Franck78/Cobra-Command/output/dataeast-EL.pdf

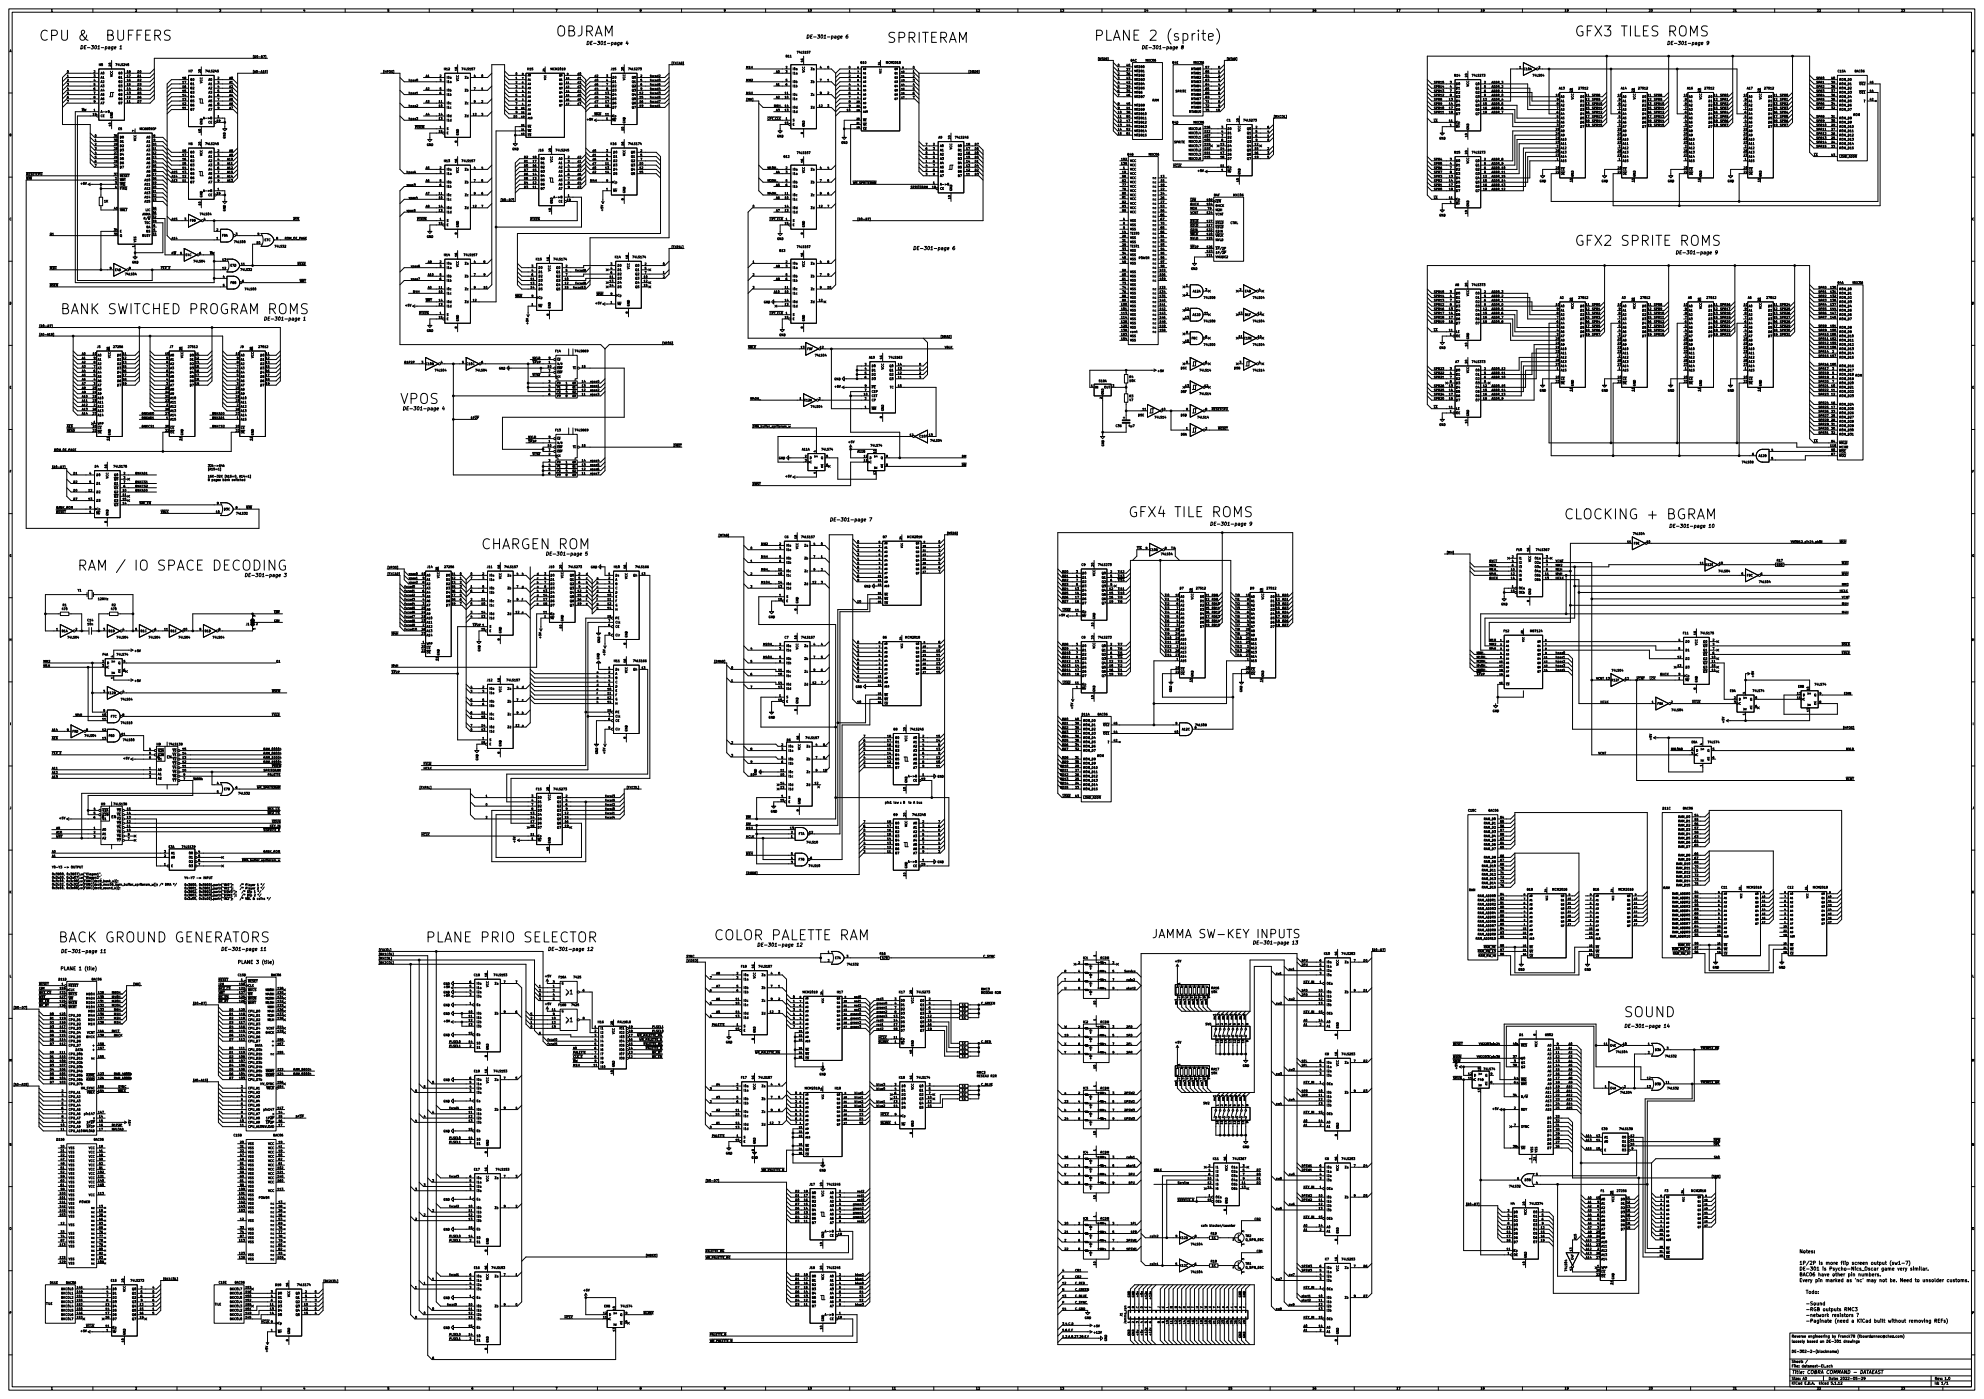
[picture p1: page 1]

BANK SWITCHED PROGRAM ROMS

DMA_buffer_spriteram_w
GND GND

8 Zc 9 C6 74LS157 Mr 1 Q2 10 Q2 11 D2 12 D3 13 Q3 14 Q3 15 VCC 16 Q0 2 Q0 3 D0 4 D1 5 Q1 6 Q1 7 GND

W RAM / IO SPACE DECODING

RMC3 RESEAU R2R BACK GROUND GENERATORS

1P/2P is more flip screen output (sw1-7)
DE-301 is Psycho-Nics_Oscar game very similar.
BAC06 have other pin numbers.
Every pin marked as 'nc' may not be. Need to unsolder customs.

-network resistors ?
-Paginate (need a KiCad built without removing REFs)

Reverse engineering by Franck78 (fbourdonnec@chez.com)
loosely based on DE-301 drawings

File: dataeast-EL.sch Sheet: / DE-302-2-(blockname)

Id: 1/1 Title: COBRA COMMAND - DATAEAST
