Franck78/Cobra-Command/dataeast-EL.sch

## KiCad design dataeast-EL.sch (2024-06-16)

Schematic: dataeast-EL.sch

Parts:
A2, A3, A5, A6, A13, A14, A16, A17: 27512; DIP-28_W15.24mm
A7, A8: 74LS373
A9: 74LS245
A10: 74LS163
A11: 74LS74
A12: 74LS08
B1: 74LS04
B4: MXC06
B6, B7, B10, B16, B18: MCM2018
B8, B9: 74LS245
B11, B12, B13: 74LS157
B14, B15: 74LS273
C1, C8, C9: 74LS273
C6, C7: 74LS157
C10: 74LS04
C11, C12: MCM2018
C14: 10n
C15: BAC06
C18: 74LS153
C36: 4µ7
D1: 6502
D3: 74LS32
D4: 74LS175
D5: 74LS14
D6: 74LS157
D7, D9: 27512; DIP-28_W15.24mm
D11: BAC06
D18: 74LS174
E3: 74LS139
E4: 74LS04
E5: MC6809EP; DIP-40_W15.24mm
E7: 74LS32
E8, E9: 74LS74
E15: 74LS273
E16, E17, E18: 74LS153
F1: 27256; DIP-28_W15.24mm
F3: MCM2018
F4: 74LS74
F7: 74LS10
F8: 74LS00
F9: 74LS04
F10: 74LS367
F11: 74LS175
F12: MB7124
F13, F14: 74LS669
F15: 74LS273
F16: 7425
F17, F18: 74LS157
H4: 74LS374
H5, H6, H7: 74LS245
H8, H9: 74LS138
H10, H11: 74LS166
H12, H13, H14: 74LS157
H15, H17, H18: MCM2018
H16: PAL16L8
IC1, IC2, IC3, IC4, IC5: RCDM
J1: SolderJumper_3_Bridged12
J5, J14: 27256; DIP-28_W15.24mm
J7, J9: 27512; DIP-28_W15.24mm
J10, J15: 74LS273
J11, J12: 74LS157
J16, J17, J18: 74LS245
K7, K8, K9, K10: 74LS253
K11: 74LS367
K12: 74LS04
K14, K15, K16, K18: 74LS174
K17: 74LS273
R1, R2, R16: 470
R3: 47
R4: 10K
R17: 680
R18, R19: 1K
RA16, RA17: 10K; R_Array_SIP9
SW1, SW2: SW1
TR1, TR2: Q_NPN_EBC
Y1: 12MHz

Notes on the sheet:
A13
A14
A15
A10
A11
A12
JAMMA SW-KEY INPUTS
RMC3 RESEAU R2R
GFX2 SPRITE ROMS
GFX4 TILE ROMS
SOUND
GFX3 TILES ROMS
BANK SWITCHED PROGRAM ROMS
32k->64k [A15=1]
16K-32K [A15=0, A14=1] 8 pages bank switched
RAM / IO SPACE DECODING
PLANE PRIO SELECTOR
OBJRAM
CHARGEN ROM
2PU
1PU
1PL
1PR
1PSW1
1PSW2
1PSW3
2PSW1
2PSW2
2PSW3
start1
2PR
2PL
1PD
2PD
start2
coin2
coin1
pin1 low : B to A bus
SPRITERAM
VPOS
Y0-Y3 -> OUTPUT 0x3800, 0x3807).w("tilegen1", 0x3a00, 0x3a07).w("tilegen2", 0x3c00, 0x3c00).w(FUNC(dec8_bank_w)); 0x3c02, 0x3c02).w(FUNC(dec8_mxc06_karn_buffer_spriteram_w)); /* DMA */ 0x3e00, 0x3e00).w(FUNC(dec8_sound_w));
Y4-Y7 -> INPUT 0x3800, 0x3800).portr("IN0"); /* Player 1 */ 0x3801, 0x3801).portr("IN1"); /* Player 2 */ 0x3802, 0x3802).portr("DSW0"); /* Dip 1 */ 0x3803, 0x3803).portr("DSW1"); /* Dip 2 */ 0x3a00, 0x3a00).portr("IN2"); /* VBL & coins */
CPU & BUFFERS
DE-301-page 1
DE-301-page 6
DE-301-page 3
DE-301-page 4
DE-301-page 5
DE-301-page 12
COLOR PALETTE RAM
PLANE 1 (tile)
PLANE 2 (sprite)
PLANE 3 (tile)
DE-301-page 10
DE-301-page 7
DE-301-page 9
DE-301-page 8
DE-301-page 11
CLOCKING + BGRAM
DE-301-page 13
DE-301-page 14
BACK GROUND GENERATORS
coin blocker/counter
YM2203pin24
Notes: 1P/2P is more flip screen output (sw1-7) DE-301 is Psycho-Nics_Oscar game very similar. BAC06 have other pin numbers. Every pin marked as 'nc' may not be. Need to unsolder customs.
Todo: -Sound -RGB outputs RMC3 -network resistors ? -Paginate (need a KiCad built without removing REFs)
